sinara-hw/DIOT_Sinara_Fan_Tray/README.md

# DIOT_Sinara_Fan_Tray
Fan tray dedicated to Sinara@DIOT
