sinara-hw/DIOT_Sinara_Fan_Tray/(list of files, drawings)

Other design files:
DIOT_FAN_TRAY_PCB/channel.SchDoc
DIOT_FAN_TRAY_PCB/Fan_control.PcbDoc
DIOT_FAN_TRAY_PCB/Fan_control.PrjPcb
DIOT_FAN_TRAY_PCB/Fan_control.SchDoc
DIOT_FAN_TRAY_PCB/Fan_tray.PcbDoc
