sinara-hw/DIOT_Sinara_Fan_Tray/(threads)

Thread 1 (2025-04-03):

DIOT fan tray

gkasprow, 2025-04-03:
The original Shcorff fan tray is an absolute disaster from the engineering point of view.
We designed four variants of the new fan tray and will give them a try using DIOT_Simulator and DIPSU
1. 2x5 80 x 80 x 10,8 mm fans, elevated
2. 2x5 80 x 80 x 10,8 mm fans, lowered (touching the rails)
3. 2x5 100x100x15mm fans, elevated
4. 2x5 100x100x15mm  fans, lowered (touching the rails)

Version 1. and 2. are in production now.

The fan unit will have single two layer board with controller ICs.

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

jordens, 2025-04-03:
Interesting. Looking forward to the tests.

Schroff tends to draw their ATCA cooling options with fans tilted in an attempt to align them with the airflow. But I guess for this configuration with so little space (30 mm?) it doesn't matter much.

All three options (DIOT fan tray, Schroff fan tray and this one) only pump air through the peripheral side and need to actively channel airflow away from RTMs and EXT PSU. This means the power on the RTM side (including the EXT PSU itself, which I had thought we could use to supply high power high voltage to e.g. IDC_HV_8CH) is very limited.

Instead of placing the fans under (DIOT fan tray) or above (Schroff or this one) the peripherals, one could consider placing them in unused RTM slots and additionally in the case of the Sinara 84 HP layout in the entire unused 20 HP rear area. Make 18 HP (would cover exactly 3 RTM slots) or 20 HP (for a 100x100mm fan) rear panels, attach a good (quiet, efficient, reliable: pick any two) fan, filter (?), and grill to it and extract the air straight through the rear panel. I can imagine that two such fans would be sufficient for Sinara (with 92 mm, 100 m³/h, 35 dBA, PWM). You would only loose two RTM slots (RTM slit behind controller is unused anyway: one fan to the right one fan to the left). You'd use the same ratiopac air crate with the foam baffle below the backplane. Block the unused rear exit in the top cover. That way you could use thick fans in their optimal orientation unblocked. It would be more dependent than the tray above or below on baffles to block the flow in unused peripheral slots. And it would obviously restrict RTM usage.

gkasprow, 2025-04-03:
This short crate doesnt have the RTM side

jordens, 2025-04-03:
Exactly.
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

jordens, 2025-04-03:
For your design and tests, it would be interesting to additionally open up the rear panel (or
 add more ventilation slots) for less resistance at the exhaust.

jordens, 2025-04-03:
And for my configuration one could add an array of 9 L-shaped baffles that channel air above the peripherals and behind the backplane to balance the flows. They could clip into the rails.

gkasprow, 2025-04-03:
I'll make this version as well and give it a try

gkasprow, 2025-04-03:
This version has one essentiak drawback - it relies on the user IQ. One needs to block unused slots and install baffles to make it working at all.

gkasprow, 2025-04-03:
@jordens can you give us some suggestions on DIOT thermal test? Or even maybe one test scenario?

jordens, 2025-04-03:
I agree that without baffles and unused slots it'll probably suck... But if you are interested I can spin a baffle shape for laser/water jet cutting to robustify it.
My money is on configuration 2. But it might also be the loudest.

Not sure I understand the question. I'd build a full crate with your variable load peripherals and set them all to 10W, 30W and record their temperatures as well as intake and exhaust temp for 0/20/100% fan in stead state where possible. And shoot some ir cam photos. For all three fan designs that's about 10 configurations (repeating the fan off config is pointless as is no fan and 30W per module).

Separately it would be interesting to have minimum airflow numbers for some given ambient temp for each existing diot peripheral. But that's another project.

gkasprow, 2025-04-03:
This is more or less what we plan to do.
Plus emulate fan failures. Plus recording temperature crosstalk to nearby slots. All suggestions are welcome. We also plan to emulate temperature profiles of typical Sinara cards. Each tester has 19 thermometers so we don't need an IR camera.

greg-daniluk, 2025-04-30:
Guys, we had similar arrangement of fans in the PXIe crate recently and experienced quite some issues with cooling the boards that would dissipate more heat. Thermal simulations revealed that we had quite some vortexes and some parts of the PCBs would get barely any airflow. Bottom-Top airflow with fans directly below the PCBs has quite some advantages.

When you test this solution, make sure you check the uniformity of the airflow through the whole PCB surface.

Cheers,
Greg (CERN, DI/OT)

jordens, 2025-05-05:
The rear panel approach -- albeit with reversed flow -- is well known and works:

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

https://www.ni.com/en/shop/pxi/ni-pxi-chassis-design-advantages.html

Should be implementable on the existing Schroff 4U crate, just with reversed covers.

greg-daniluk, 2025-05-06:
Sure, I'm not saying it's something exotic. I'm saying that if you want to implement it, it would be useful to do some airflow simulations to make sure it's uniformly covering PCBs in the front.

Cheers,
Greg

gkasprow, 2025-05-13:
@martafafara I uploaded the fantray controller PCB. Please have a look

martafafara, 2025-05-16:
@gkasprow I have some remarks:

- [ ] IC1 (TCA9548) has no filtering capacitance at VCC pin
- [ ] I'm not sure how it would connect with the rest of DIOT? You've insisted on to use different solution than proposed in issue [DIOT_Backplane](https://github.com/sinara-hw/DIOT_Backplane/issues/5) . In consequence I'm unable to verify everything
- [ ] "Generic No ERC" marks at intentionally unconnected nets could be helpful
- [ ] R2 and R3 pull-up is not redundant according to the rest of I2C interface?
- [ ] Connectors J5 and J6 are rotated comparing to the rest. I don't have full model, so I can not check if it's correct.
- [ ] Consider soldermask opening at the top side to improve thermal management of IC1
- [ ] Why traces on both sides of IC2 has different width? The current should be the same.
- [ ] C7s could be closer to the IC3s.
- [ ] Mounting holes shoudl not have connection to CHASSIS?

Please, reply to this point and I will check further.

gkasprow, 2025-05-19:
> I'm not sure how it would connect with the rest of DIOT? You've insisted on to use different solution than proposed in issue https://github.com/sinara-hw/DIOT_Backplane/issues/5 . In consequence I'm unable to verify everything

We have two connectors. One is direct connection to the backplane using four wall header soldered directly to the pads. The second one uses proprietary adapter board developed by TS
Rest of the issues will be addressed by Mariusz

gkasprow, 2025-05-19:
@emmroz

martafafara, 2025-05-19:
- [ ] Connector J1 pinout do not correspond to [DIOT Backplane Mezzaine](https://github.com/sinara-hw/DIOT_Backplane_Mezzanine)
- [ ] C3 should be connected like i.e. C8 to improve filtering

emmroz, 2025-05-19:
@martafafara thank you for your remarks. Please find answers below. I also pushed a new commit.
-C1 (TCA9548) has no filtering capacitance at VCC pin
**Fixed**
"Generic No ERC" marks at intentionally unconnected nets could be helpful
**Fixed**
R2 and R3 pull-up is not redundant according to the rest of I2C interface?
**R2 and R3 can stay. They do not interfere with the operation**
Connectors J5 and J6 are rotated comparing to the rest. I don't have full model, so I can not check if it's correct.
**I consulted it with @gkasprow  it is correct**
Consider soldermask opening at the top side to improve thermal management of IC1
**Fixed**
Why traces on both sides of IC2 has different width? The current should be the same.
**Fixed**
C7s could be closer to the IC3s.
**Fixed**
Mounting holes shoudl not have connection to CHASSIS?
**They should be isolated**
Connector J1 pinout do not correspond to DIOT Backplane Mezzaine
**This is alternative connector with alternativve pinout**
C3 should be connected like i.e. C8 to improve filtering
**Fixed**

martafafara, 2025-05-20:
> Connector J1 pinout do not correspond to DIOT Backplane Mezzaine
> This is alternative connector with alternativve pinout

According to @gkasprow :
> We have two connectors. One is direct connection to the backplane using four wall header soldered directly to the pads. The second one uses proprietary adapter board developed by TS
So at least one should be matched.

Plated holes when screwed to the chassis will have CHASSIS potential anyway. Consider using NPTH or increase the clearance between GND and hole plating.

Additional remarks:
- [ ] If v-cut would be applied, then board outline clearance should be increased. Even for milling the clearance is too small.
- [ ] clear the DRC errors (mark "Ignore Pad to Pad clearances within a footprint" checkbox in Clearance rule)

emmroz, 2025-05-27:
@martafafara
I had to redesign PCB layout due to power demands of fans (each fan needs up to 0,6A). I also changed mounting holes to not plated. For v-cut,, the board outline clearance for tracks - 0,3mm is sufficient

martafafara, 2025-05-28:
@emmroz

- [ ] The pinout is still inconsistent
- [ ] clearance of 0.3 is a the minimum recommended clearance that not all manufacturers offers as standard pool. Anyway, it is not met at the bottom.
- [ ] the componenet celarance should be higher - 2 mm will be enough. Especially recommended for small ceramics. There is a lot space for that

martafafara, 2025-05-30:
According to pinout you can see the difference in the picture below. I set side by side both projects - your and [Backplane Mezzaine](https://github.com/sinara-hw/DIOT_Backplane_Mezzanine). The cable is straight, no crosses, so they should match face to face with accuracy to rotation (one is on Top and the second is on the Bottom) or whole cable twist. Even looking at the I2C pins, you can simply notice the difference.

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

Copper clearance is now met.

The component clearance - I thought that you will shift only the IC1 and IC2 with their surroundings a little bit lower. Moving he transistors changes the temperature probing points and I'm not sure how it will impact the functionality, especially that they rather met the requirements.

The I2C - I know, that perfection will be never achieved, therefore I suggested only small improvements. In current version I'm not sure how to correct it. As you can see in the picture below that even in only small area the reference plane for the traces on the Top changes 2 times

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

The proposed solution do not fixes the problem, because in the longest part of this traces they are referenced to P12V and the GND changes the potential. I'm afraid that previously it looked better.

I'm also intrigued about the purpose of that layer change - I suppose that it is the consequence of previous design, but clear it please.

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

martafafara, 2025-06-03:
@emmroz
Maybe it would be something to improve, but it's not worth the further work. If any problem will occur in field then the redesign may be considered, but as for now I do not predict such necessity.
The only thing I can not left unchanged is the pinout. None of connectors match with DIOT_Backplane_Mezzaine. If J1 is the alternative one, then J2 should match in pinout and in connector type. But it's not met.

Thread 5 (2025-06-25):

DIOT fantray results CUSTOM 100 BACKPLANE

knorowski, 2025-06-25:
Fan setting: 4 fans 100x100mm mounted on the back flap of the device (behind the card backplane)
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

jordens, 2025-06-30:
Just to check: you blocked the short circuits and the baffles didn't fit one slot further to the right?

The successful approach (see other issue) uses turning vanes. We'd probably need that.
And the apparently even better approach is flipping the top/bottom covers, putting the baffles+vanes at the bottom and having the fans blow to the cards.

jordens, 2025-07-01:
Both the backplane area but also the black foam block glued to the lower crate cover under the lower middle horizontal rail. It looks like it might be there.

I don't think a test with a different baffle placement will do much difference here (they probably would make a difference in a half-empty crate). My guess is that turning vanes on the baffles and the reversed flow would be much more interesting.

The upper red guide of the PSU looks bent/misplaced/broken.

knorowski, 2025-07-01:
Results for the reverse flow.
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

knorowski, 2025-07-01:
I understand we aim to test the situation from Fig 2 of this scheme?

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

so i should have :
- fan exhaust on top cover, front panel
- air intake on rear, and airholes of bottom cover also on rear
- baffles mounted from topside

jordens, 2025-07-01:
Baffles bottom. Ignore the side exhausts and just turn the crate upside down if you want to test this. No need to modify things. See also the simulation images.

knorowski, 2025-07-02:
Measurement of the flipped box
\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
