sinara-hw/DIOT_Sinara_Fan_Tray/(commit log)

2025-05-19 changes according to issue https://github.com/sinara-hw/DIOT_Sinara_Fan_Tray/issues/1
    [Fan_control.PcbDoc, Fan_control.PrjPcb, Fan_control.SchDoc, channel.SchDoc]
2025-05-27 PCB redesign - added P12V0 and P3V3 polygons. Chenged components placement.
    [Fan_control.PcbDoc, Fan_control.PrjPcb]
2025-05-28 change components clearance change board outline rule
    [Fan_control.PcbDoc]
2025-05-29 layout improvement
    [Fan_control.PcbDoc]
2025-06-02 redesign: remowed P3V3 polygon - added GND polygon instead.
    [Fan_control.PcbDoc]
